SandwichRising/Sundial/media/v1_hardcopy_schematic.jpg

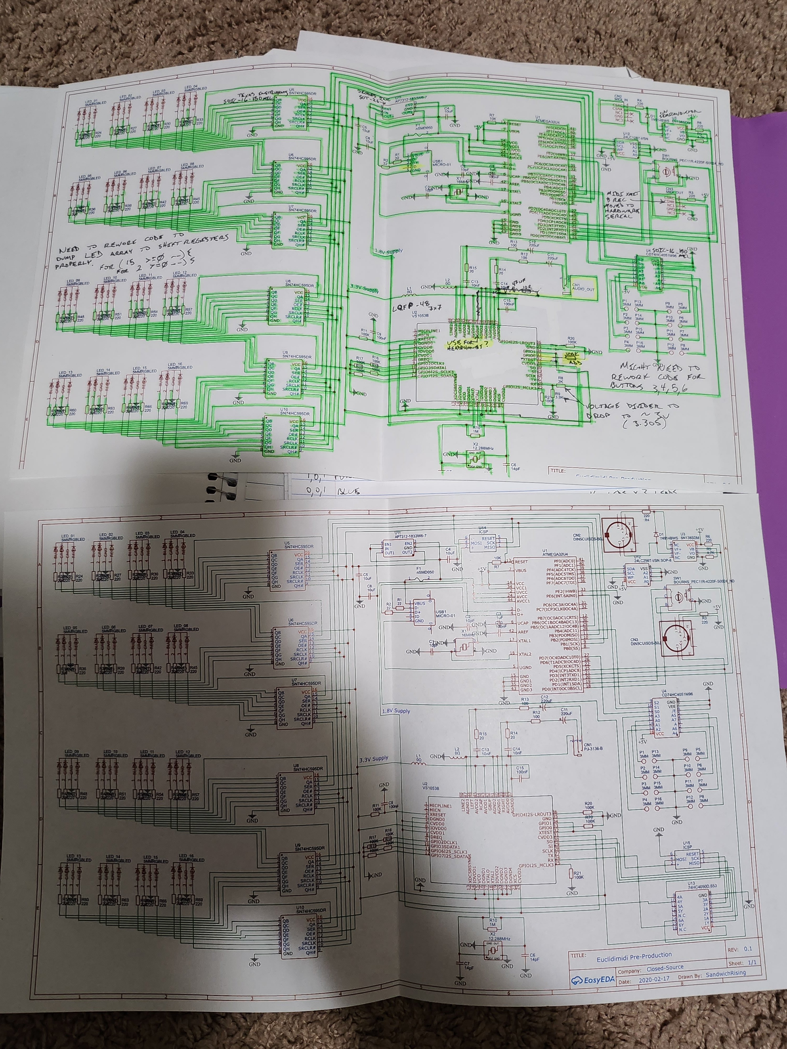
media/v1_hardcopy_schematic.jpg
