SandwichRising/Sundial/assets/BOM_Main_v3_2023-08-20.csv

ID | Name | Designator | Footprint | Quantity | Manufacturer Part | Manufacturer | Supplier | Supplier Part | Price
1 | BOURNS_PEC11R-4220F-S0024_ND | SW1 | BOURNS_PEC11R-4XXXF-SXXXX | 1
2 | TS-1103S-B-M | SW2,SW3,SW4,SW5,SW6 | SW-SMD_4P-L12.0-W12.0-P5.00-LS15.4 | 5
3 | TS-1102S-B-M-B | SW7,SW8,SW9 | SW-SMD_4P-L6.0-W6.4-P4.50-LS8.6 | 3
4 | WS2812D-F8 | LED_1,LED_2,LED_3,LED_4,LED_5,LED_6,LED_7,LED_8,LED_9,LED_10,LED_11,LED_12,LED_13,LED_14,LED_15,LED_16 | LED-TH_WS2812D-F8 | 16
5 | FC-D1608HYK-588J | RX_LED,TX_LED | LED0603-RD | 2
6 | 1K | R45,R46,R7,R34 | R0603 | 4
7 | MTP125-1102S1 | 5V_OUT,GND_OUT,U15,U16,U6,U8,U10,U9 | HDR-TH_2P-P2.54-V_A2541HWV-2P | 8
8 | PZ254V-11-01P | PIN_11,PIN_A1,PIN_13,PIN_7,PIN_5,A_GND,LT_OUT,RT_OUT | HDR-TH_1P-P2.54-V-M | 8
9 | 360 | R44,R40,R39,R41,R43,R42,R36,R35,R8,R9,R11,R16,R17,R21,R22,R23,R24,R25,R26,R27,R28,R29,R30,R31,R32 | R0603 | 25
10 | SK12D07VG4 | PWR_SW | SW-TH_SK12D07VG4 | 1
11 | 0.1" Pitch | SHIELD_1,SHIELD_2 | HDR-TH_10P-P2.54-V-R2-C5-S2.54_MTP125-1205S1 | 2
12 | DIN5CUISDS-50J | MIDI_IN,MIDI_OUT | DIN5 | 2
13 | ICSP | U14,U5 | HEADER_PRG_2X03 | 2
14 | 1N914BWS | D2,D3,D1 | SOD-323_L1.8-W1.3-LS2.5-RD | 3
15 | 100K | R37,R38,R6,R18,R19,R20 | R0603 | 6
16 | TXB0104RGYR | U7 | VQFN-14_L3.5-W3.5-P0.50-BL-EP | 1
17 | 10pF | C1,C2 | C0603 | 2
18 | 1uF | C3 | C0603 | 1
19 | 10uF | C4,C5,C8 | C0603 | 3
20 | 15pF | C6,C7 | C0603 | 2
21 | 100nF | C9,C10,C15,C16,C17,C18,C19,C20,C21,C22,C23,C24,C25,C26,C27,C28,C29,C30,C31 | C0603 | 19
22 | 220uF | C11,C12 | CAP-SMD_BD6.3-L6.6-W6.6-FD | 2
23 | 10nF | C13,C14 | C0603 | 2
24 | PJ-3136-B | CN1 | AUDIO-TH_PJ-3136-B | 1
25 | 0Ω | L1,L2 | L0805 | 2
26 | 22 | R1,R2 | R0603 | 2
27 | 220 | R3,R4,R5 | R1206 | 3
28 | 1M | R10 | R0603 | 1
29 | 100 | R12,R13 | R0805 | 2
30 | 20 | R14,R15 | R0805 | 2
31 | 560 | R33 | R0603 | 1
32 | 100K | RN1,RN2,RN3 | RES-ARRAY-SMD_0603-8P-L3.2-W1.6-BL | 3
33 | ATMEGA32U4-AU | U1 | QFP-44_L10.0-W10.0-P0.80-LS13.2-BL | 1
34 | VS1053B | U2 | LQFP-48_L7.0-W7.0-P0.50-LS9.0-TL | 1
35 | 6N138SDM | U3 | SOP-8_L9.8-W6.6-P2.54-LS10.3-BL | 1
36 | CD74HC4051M96 | U4 | SOIC-16_L9.9-W3.9-P1.27-LS6.0-BL | 1
37 | AP7312-1833W6-7 | U11 | SOT-26_L3.0-W1.6-P0.95-LS2.8-BL | 1
38 | CAT24C512WI-GT3 | U12 | SOIC-8_L4.9-W3.9-P1.27-LS6.0-BL | 1
39 | 16MHz | X1 | OSC-SMD_4P-L3.2-W2.5-BL | 1
40 | 12.288MHz | X2 | OSC-SMD_4P-L3.2-W2.5-BL | 1
41 | nSMD050 | F1 | F1206 | 1
42 | USB PLUG type B C46392 | USB1 | USB PLUG C46392 | 1
