SandwichRising/Sundial/(list of files, drawings)

Other design files:
assets/PCB_Main_v3_2023-08-20.json
